willrea/mbedTNC/mbedTNC.brd

## EAGLE design mbedTNC.brd (2014-08-08)

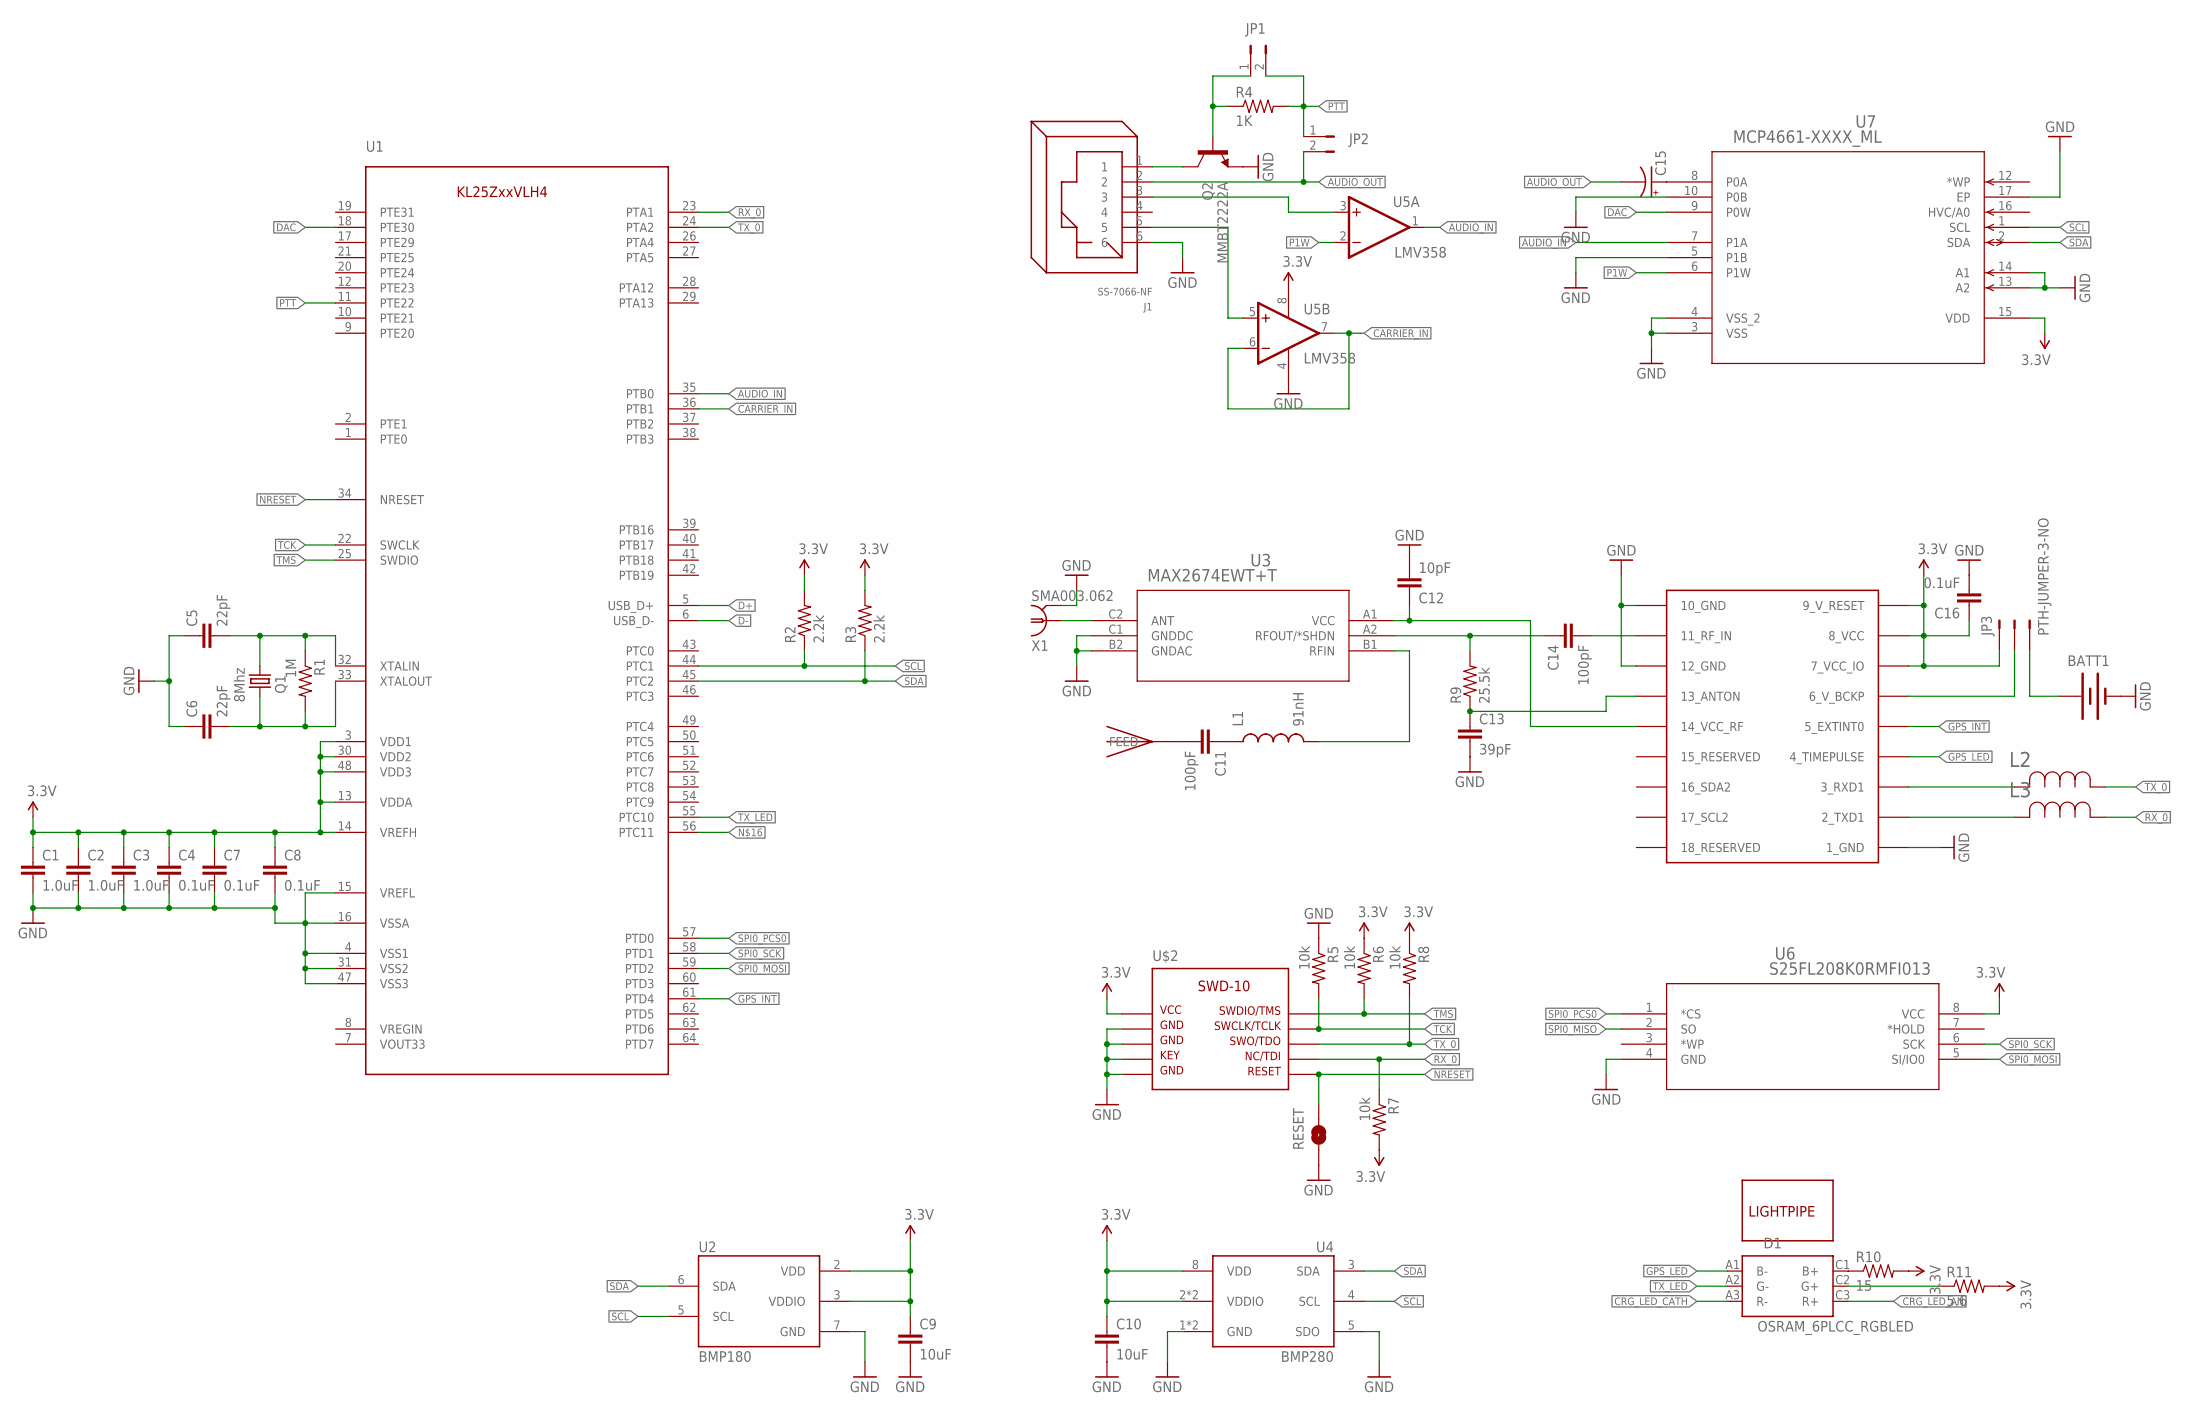
[picture p1: schematic mbedTNC.sch, sheet 1]

Parts:
BATT1: BK-890; BATTCON_12MMPC; MPN BK-890
C1, C2, C3: 1.0uF; 0603-CAP; MPN EMK107B7105KA-T
C4, C7, C8, C16: 0.1uF; 0603-CAP; MPN GRM188R71C104KA01D
C5, C6: 22pF; 0603-CAP; MPN C1608C0G1H220J080AA
C9, C10: 10uF; 0805; MPN CC0805KKX5R6BB106
C11, C14: 100pF; 0603-CAP; MPN CL10B101KB8NNNC
C12: 10pF; 0603-CAP; MPN CL10C100CB8NNNC
C13: 39pF; 0603-CAP; MPN CL10C390JB8NNNC
C15: UWX1C100MCL2GB; PCAP_4X5.4-ELECT; MPN UWX1C100MCL2GB
D1: OSRAM_6PLCC_RGBLED; LRTB-GFTM; MPN LRTBGFTM-ST7-1+VV9-29+Q5R
J1: SS-7066-NF; MPN SS-7066-NF
JP1, JP2: JUMPER-PTH-2-NO; PTH-JUMPER-2-NO_NO_SILK
JP3: PTH-JUMPER-3-NO
L1: 91nH; 0603; MPN LQW18AN91NJ00D
L2, L3: BLM18HG102SN1D; IND_BLM18_0603; MPN BLM18HG102SN1D
Q1: 8Mhz; CRYSTAL_5X3.2; MPN 7A-8.000MAAJ-T
Q2: MMBT2222A; SOT23-3; MPN MMBT2222ALT3G
R1: 1M; 0603-RES; MPN RMCF0603FT1M00
R2, R3: 2.2k; 0603-RES; MPN RMCF0603JT2K20
R4: 1K; 0603-RES; MPN RMCF0603JT1K00
R5, R6, R7, R8: 10k; 0603-RES; MPN RNCP0603FTD10K0
R9: 25.5k; 0603-RES; MPN RMCF0603FT25K5
R10: 15; 0603-RES; MPN RMCF0603JT15R0
R11: 5.6; 0603-RES; MPN RMCF0603FT5R60
RESET: JUMPER-PAD-2-NOYES_SILK; PAD-JUMPER-2-NO_YES_SILK
U1: MKL25ZXXVLH4; 64-LQFP; MPN MKL25ZXXVLH4
U2: BMP180
U3: MAX2674EWT+T; 21-0217D_W61B1-1; MPN MAX2674EWT+T
U4: BMP280
U5: LMV358; DDU8-M; MPN LMV358IDDUR
U6: S25FL208K0RMFI013; SO-8_SOA008; MPN S25FL208K0RMFI013
U7: MCP4661-XXXX_ML; QFN16_4X4MC; MPN MCP4661T-103E/ML
U$1: JTI_ANTENNA-1575AT43A40; MPN 1575AT43A0040E
U$2: SWD-10; M50-3600542
U$3: UBLOX_MAX; MPN MAX-7Q
U$4: VLP-ZZZ-X; MPN VLP-500-F
X1: SMA003.062; MPN consma003.062

Connections:
3.3V: C1.1, C2.1, C3.1, C4.1, C7.1, C8.1, C9.1, C10.1, C16.1, JP3.1, R2.2, R3.2, R6.1, R7.2, R8.1, R10.2, R11.2, U1.3 (VDD1), U1.13 (VDDA), U1.14 (VREFH), U1.30 (VDD2), U1.48 (VDD3), U2.2 (VDD), U2.3 (VDDIO), U4.2 (VDDIO), U4.6 (VDDIO), U4.8 (VDD), U5.8 (V+), U6.8 (VCC), U7.15 (VDD), U$2.P$1 (1), U$3.7_VCC_IO, U$3.8_VCC, U$3.9_V_RESET; also elsewhere on the board
AUDIO_IN: U1.35 (PTB0), U5.1 (OUT), U7.7 (P1A)
AUDIO_OUT: C15.2 (-), J1.2, JP2.2
CARRIER_IN: U1.36 (PTB1), U5.6 (-IN), U5.7 (OUT)
CRG_LED_AN: D1.C3 (R+); also elsewhere on the board
CRG_LED_CATH: D1.A3 (R-); also elsewhere on the board
D+: U1.5 (USB_D+); also elsewhere on the board
D-: U1.6 (USB_D-); also elsewhere on the board
DAC: U1.18 (PTE30), U7.9 (P0W)
GND: BATT1.C1 (-), C1.2, C2.2, C3.2, C4.2, C5.1, C6.1, C7.2, C8.2, C9.2, C10.2, C12.2, C13.2, C16.2, J1.6, Q2.2 (E), R5.1, RESET.1, U1.4 (VSS1), U1.15 (VREFL), U1.16 (VSSA), U1.31 (VSS2), U1.47 (VSS3), U2.7 (GND), U3.B2 (GNDAC), U3.C1 (GNDDC), U4.1 (GND), U4.5 (SDO), U4.7 (GND), U5.4 (V-), U6.4 (GND), U7.3 (VSS), U7.4 (VSS_2), U7.5 (P1B), U7.10 (P0B), U7.13 (A2), U7.14 (A1), U7.17 (EP), U$2.P$3 (3), U$2.P$5 (5), U$2.P$7 (7), U$2.P$9 (9), U$3.1_GND, U$3.10_GND, U$3.12_GND, X1.C2 (2), X1.C3 (2), X1.C4 (2), X1.C5 (2); also elsewhere on the board
GPS_INT: U1.61 (PTD4), U$3.5_EXTINT0
GPS_LED: D1.A1 (B-), U$3.4_TIMEPULSE
N2: C14.2, U$3.11_RF_IN
unnamed: C11.2, U$1.FEED
unnamed: C14.1, R9.2, U3.A2 (RFOUT/*SHDN)
unnamed: J1.1, Q2.3 (C)
unnamed: L1.2, U3.B1 (RFIN)
unnamed: JP3.2, U$3.6_V_BCKP
unnamed: C12.1, U3.A1 (VCC), U$3.14_VCC_RF
unnamed: C5.2, Q1.P$2 (2), R1.1, U1.32 (XTALIN)
unnamed: C6.2, Q1.P$1 (1), R1.2, U1.33 (XTALOUT)
unnamed: D1.C2 (G+), R11.1
unnamed: D1.C1 (B+), R10.1
unnamed: C11.1, L1.1
unnamed: L2.2, U$3.3_RXD1
unnamed: C15.1 (+), U7.8 (P0A)
unnamed: J1.3, U5.3 (+IN)
unnamed: L3.2, U$3.2_TXD1
unnamed: JP1.1, Q2.1 (B), R4.1
unnamed: J1.5, U5.5 (+IN)
unnamed: U3.C2 (ANT), X1.RF (1)
unnamed: C13.1, R9.1, U$3.13_ANTON
unnamed: BATT1.C2 (+), BATT1.C3 (+), JP3.3
NRESET: RESET.2, U1.34 (NRESET), U$2.P$10 (10)
P1W: U5.2 (-IN), U7.6 (P1W)
PTT: JP1.2, JP2.1, R4.2, U1.11 (PTE22)
RX_0: L3.1, R7.1, U1.23 (PTA1), U$2.P$8 (8)
SCL: R2.1, U1.44 (PTC1), U2.5 (SCL), U4.4 (SCL), U7.1 (SCL)
SDA: R3.1, U1.45 (PTC2), U2.6 (SDA), U4.3 (SDA), U7.2 (SDA)
SPI0_MISO: U6.2 (SO)
SPI0_MOSI: U1.59 (PTD2), U6.5 (SI/IO0)
SPI0_PCS0: U1.57 (PTD0), U6.1 (*CS)
SPI0_SCK: U1.58 (PTD1), U6.6 (SCK)
TCK: R5.2, U1.22 (SWCLK), U$2.P$4 (4)
TMS: R6.2, U1.25 (SWDIO), U$2.P$2 (2)
TX_0: L2.1, R8.2, U1.24 (PTA2), U$2.P$6 (6)
TX_LED: D1.A2 (G-), U1.55 (PTC10)

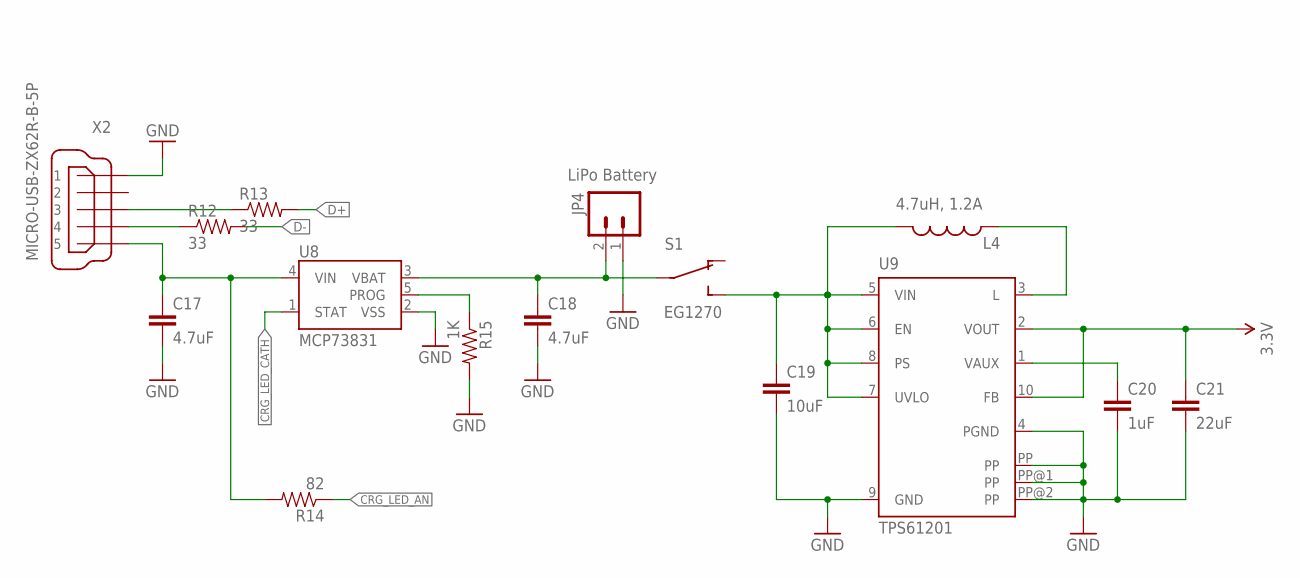
[picture p2: schematic mbedTNC.sch, sheet 2]

Parts:
C17, C18: 4.7uF; 0805; MPN CL21B475KOFNNNE
C19: 10uF; 0805; MPN CL21A106KOQNNNE
C20: 1uF; 0603-CAP; MPN EMK107B7105KA-T
C21: 22uF; 1206; MPN CL31A226KOCLFNC
JP4: LiPo Battery; JST-2-SMD; MPN S2B-PH-SM4-TB(LF)(SN)
L4: 4.7uH, 1.2A; CDRH2D09; MPN CDRH2D18/HPNP-4R7NC
R12, R13: 33; 0603-RES; MPN RMCF0603FT33R0
R14: 82; 0603-RES; MPN ESR03EZPJ820
R15: 1K; 0603-RES; MPN RMCF0603JT1K00
S1: EG1270; MPN EG1270
U8: MCP73831; SOT23-5; MPN MCP73831
U9: TPS61201; S-PDSO-N10
X2: MICRO-USB-ZX62R-B-5P; ZX62R-B-5P; MPN ZX62R-B-5P

Connections:
3.3V: C21.1, U9.2 (VOUT), U9.10 (FB); also elsewhere on the board
CRG_LED_AN: R14.1; also elsewhere on the board
CRG_LED_CATH: U8.1 (STAT); also elsewhere on the board
D+: R13.2; also elsewhere on the board
D++: R13.1, X2.3
D-: R12.2; also elsewhere on the board
D--: R12.1, X2.4
GND: C17.2, C18.2, C19.2, C20.2, C21.2, JP4.1, R15.2, U8.2 (VSS), U9.4 (PGND), U9.9 (GND), U9.PP, U9.PP@1 (PP), U9.PP@2 (PP), X2.1; also elsewhere on the board
unnamed: C17.1, R14.2, U8.4 (VIN), X2.5
unnamed: C18.1, JP4.2, S1.P$2, U8.3 (VBAT)
unnamed: L4.P$1 (1), U9.3 (L)
PROG1: R15.1, U8.5 (PROG)
VAUX: C20.1, U9.1 (VAUX)
VIN: C19.1, L4.P$2 (2), S1.P$3 (O2), U9.5 (VIN), U9.6 (EN), U9.7 (UVLO), U9.8 (PS)

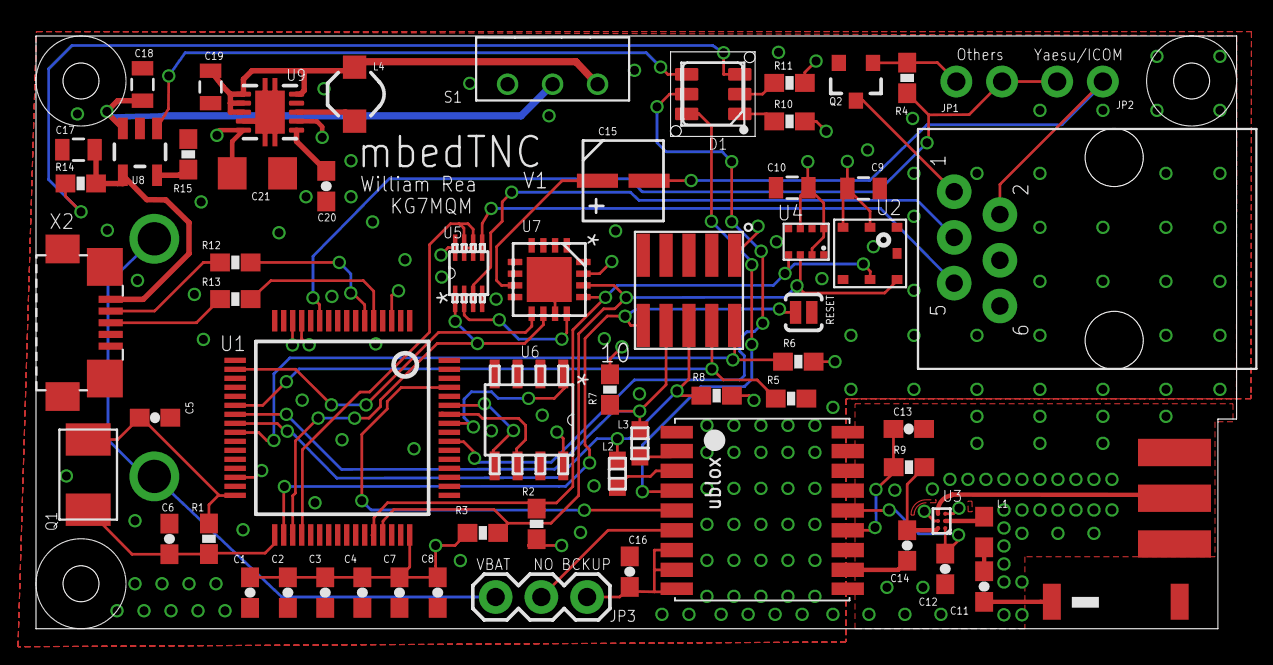
[picture p3: board mbedTNC.brd from above]

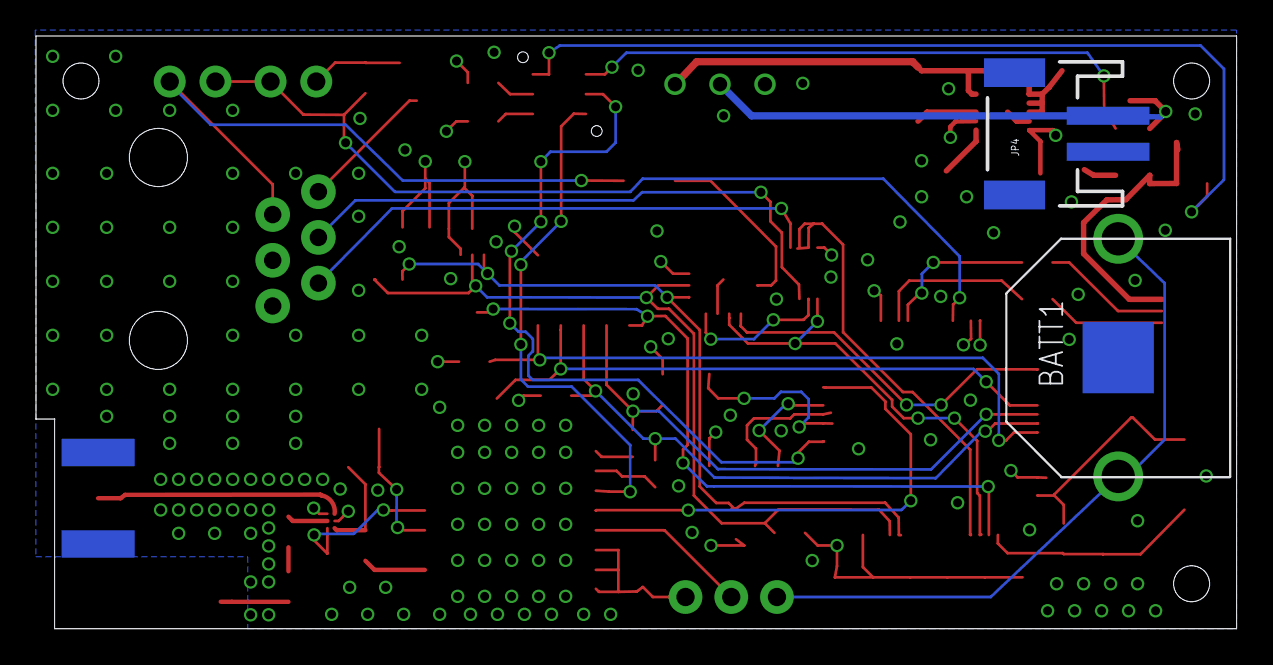
[picture p4: board mbedTNC.brd from below]

Board: 4 copper layers, 66.7 x 32.9 mm, 66 parts (2 on the bottom side), 54 nets.
