willrea/mbedTNC/(commit log)

2014-07-17 Initial commit.
    [mbedTNC.brd, mbedTNC.sch]
2014-07-19 Update
    Added support for Yaesu/Icom radios. Moved components around.
    [mbedTNC.brd, mbedTNC.sch]
2014-07-22 Update
    Changed to a 2 circuit digipot. Various other changes
    [mbedTNC.brd, mbedTNC.sch]
2014-08-01 Update.
    Move to 4 layer board. New LNA with internal switch for an active
    external ant. Finalizing parts, moved stuff around.
    [mbedTNC.brd, mbedTNC.sch]
2014-08-02 Update
    Moved some components around to accommodate case design
    [mbedTNC.brd, mbedTNC.sch]
2014-08-08 Version 1
    [mbedTNC.brd, mbedTNC.sch]
